adricom231/IV-3-Clock/My IV-3 Fusion360 Library/Schematic View.png

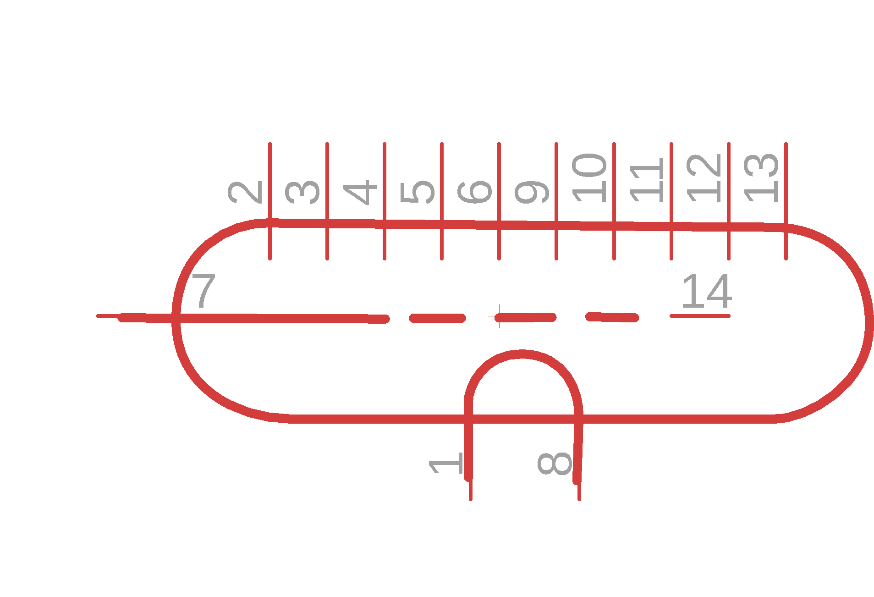
My IV-3 Fusion360 Library/Schematic View.png
