adricom231/IV-3-Clock/PCB/Botom all.png

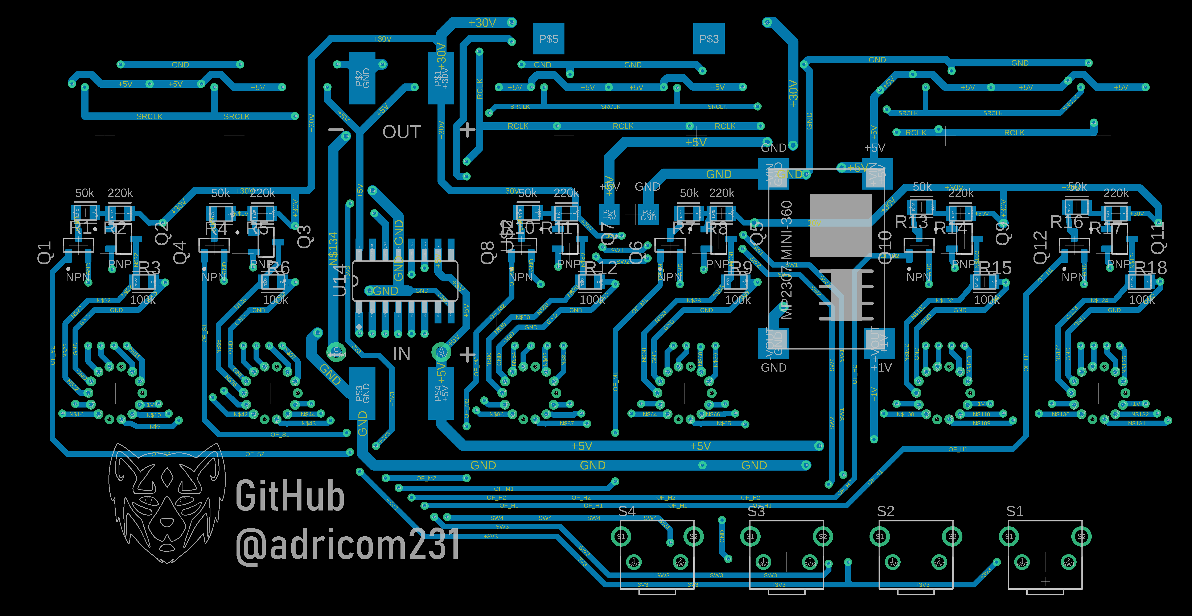
PCB/Botom all.png
