adricom231/IV-3-Clock/PCB/Botom copper.png

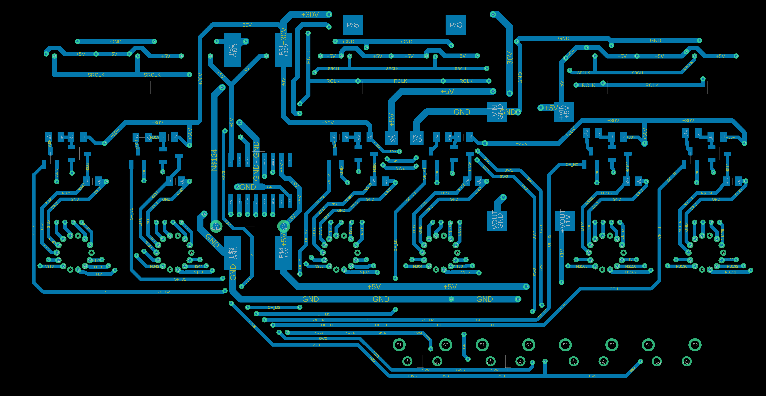
PCB/Botom copper.png
