adricom231/IV-3-Clock/PCB/Botom Silkscreen.png

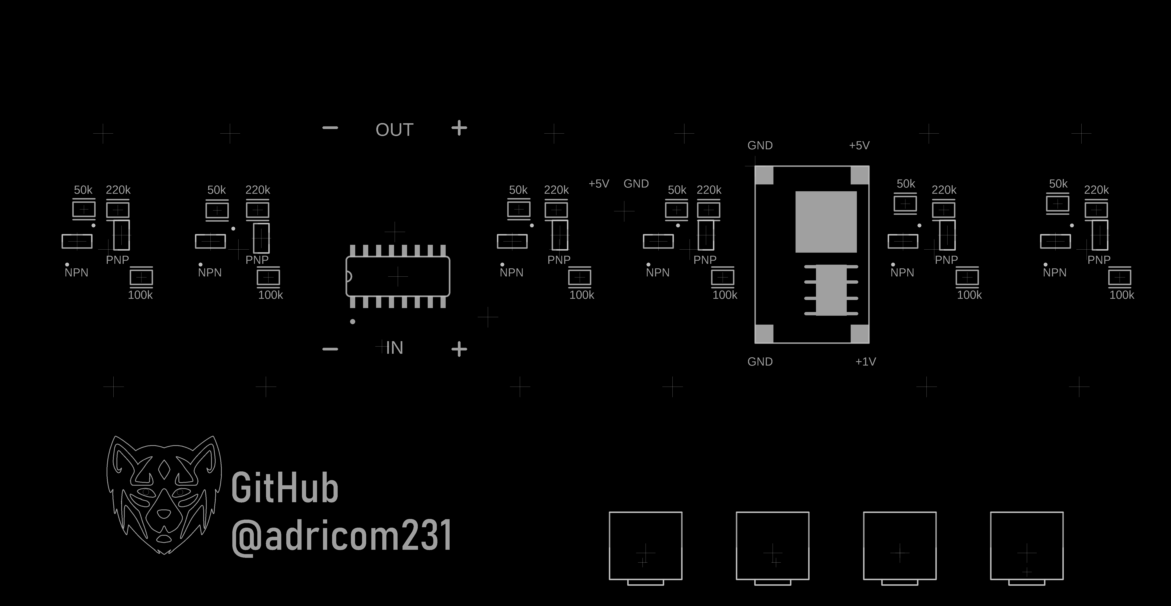
PCB/Botom Silkscreen.png
