adricom231/IV-3-Clock/PCB/botom vias&pads.png

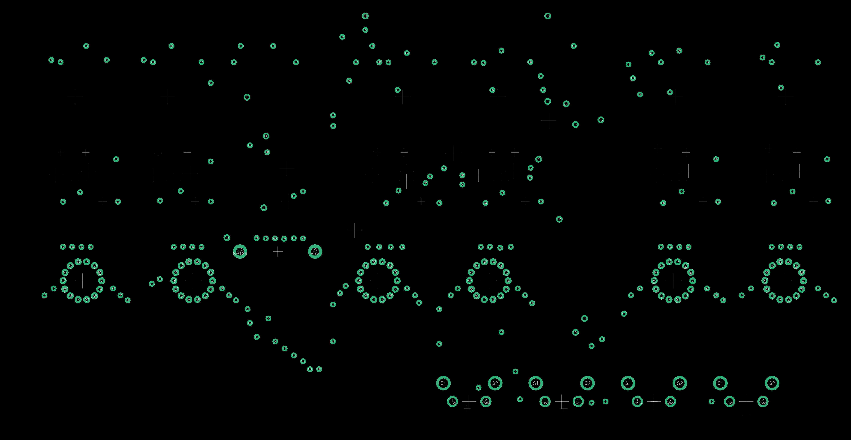
PCB/botom vias&pads.png
