adricom231/IV-3-Clock/PCB/Top all.png

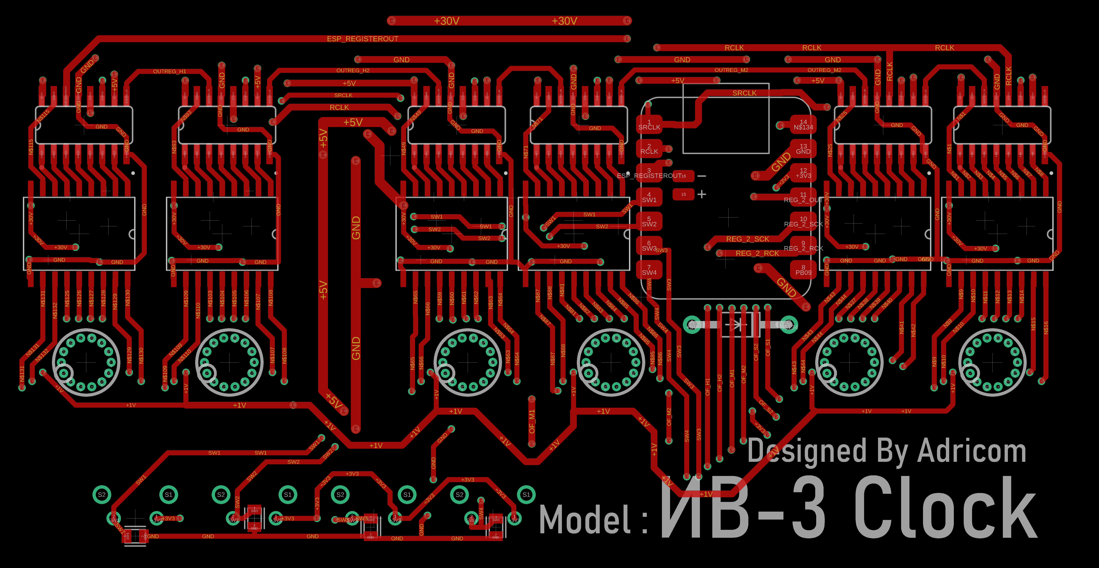
PCB/Top all.png
