adricom231/IV-3-Clock/PCB/Top copper.png

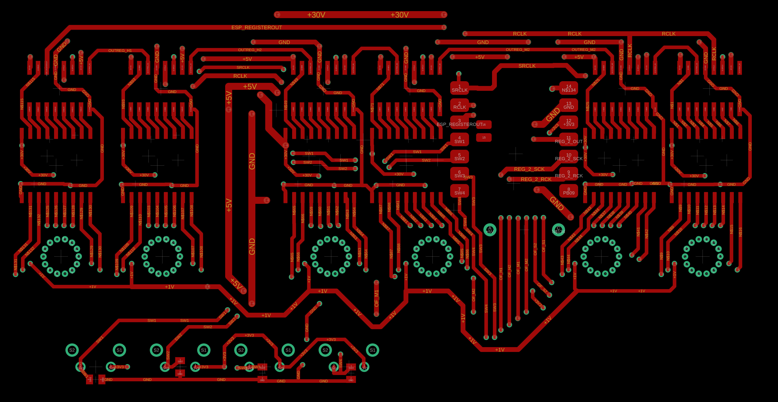
PCB/Top copper.png
