adricom231/IV-3-Clock/PCB/Top silkscreen.png

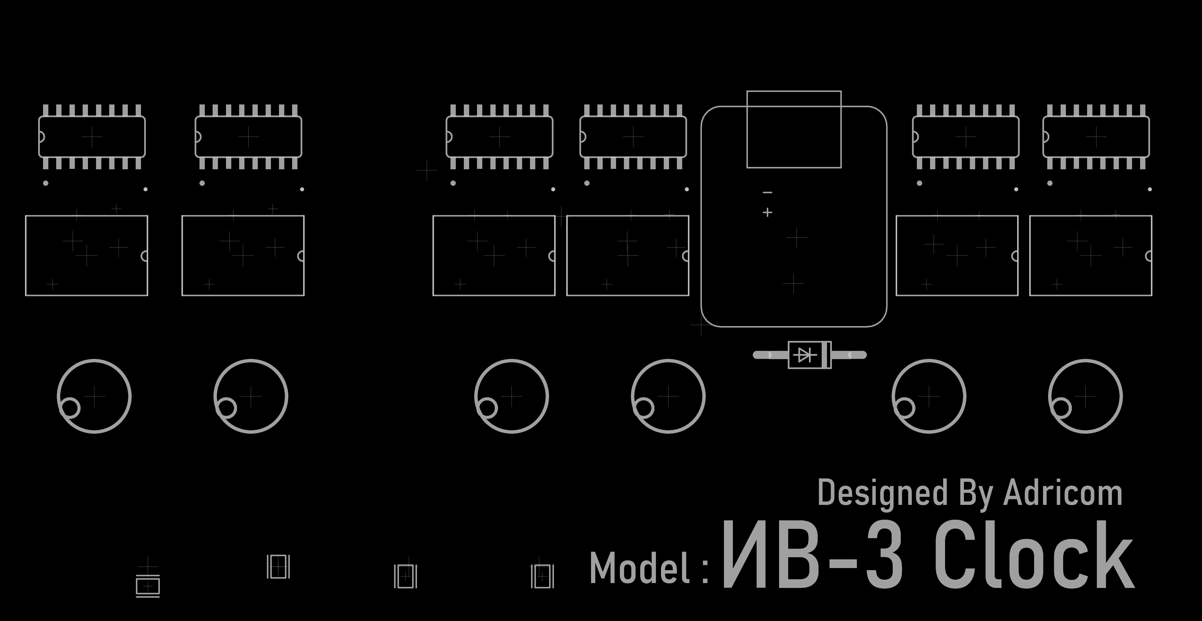
PCB/Top silkscreen.png
