adricom231/IV-3-Clock/PCB/Top vias&pads.png

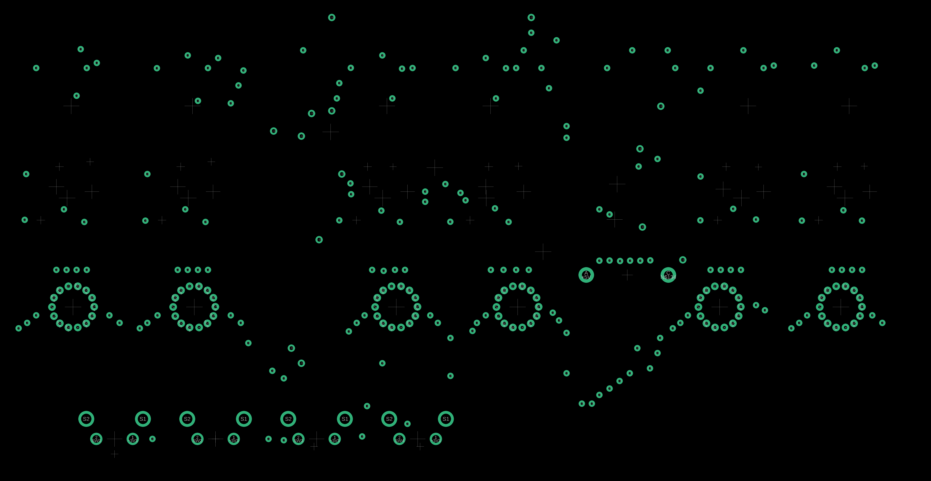
PCB/Top vias&pads.png
