adricom231/IV-3-Clock/Schematics/image.png

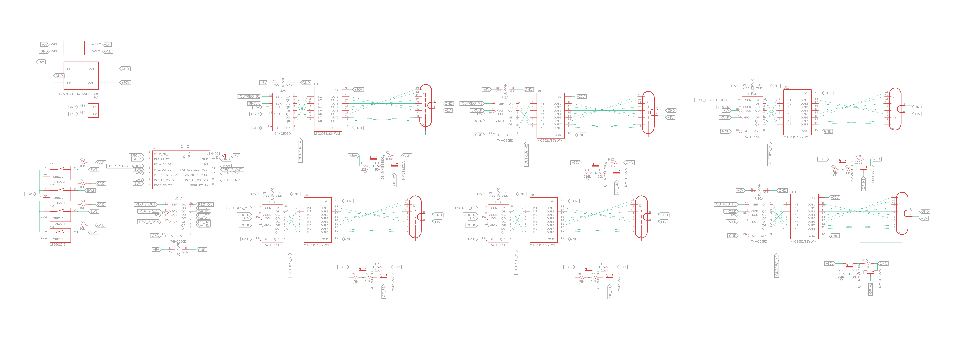
Schematics/image.png
