adricom231/IV-3-Clock/Schematics/iv-3 tube pinout.jpg

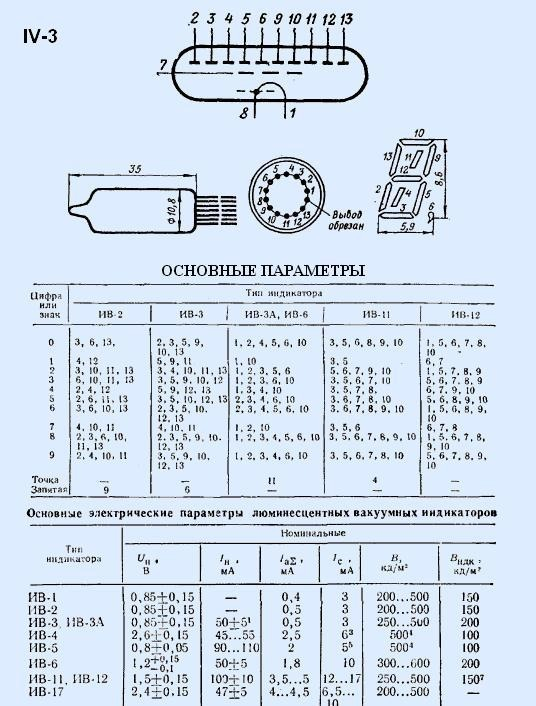
Schematics/iv-3 tube pinout.jpg
